WEkigai/Precius/Assets/Renders/Rendered_images/4.png

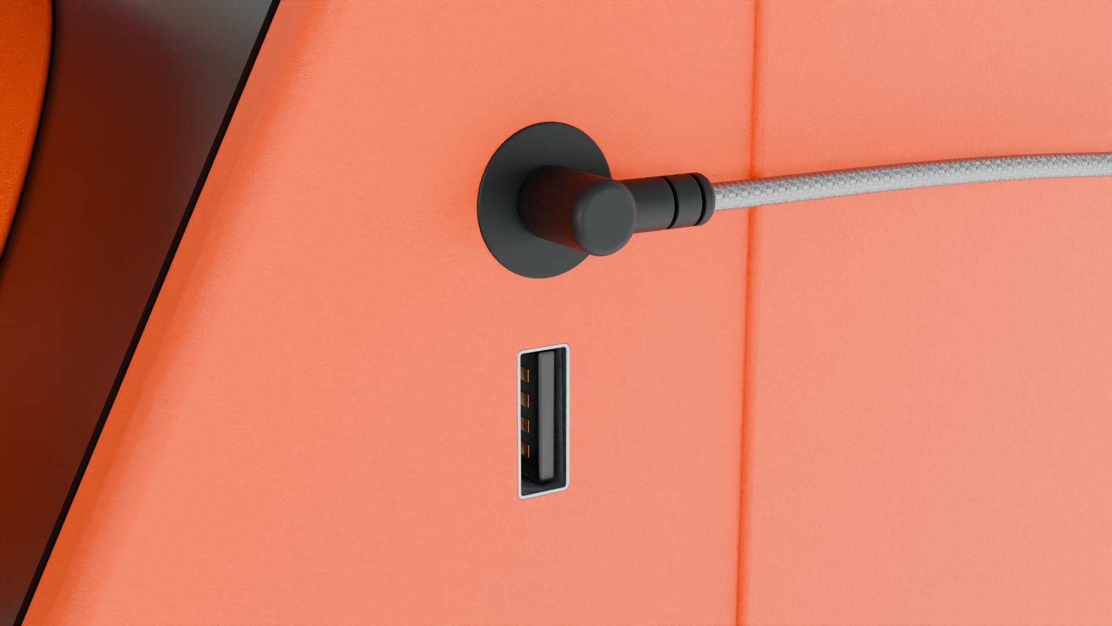
Assets/Renders/Rendered_images/4.png
