WEkigai/Precius/Assets/Renders/Rendered_images/2.png

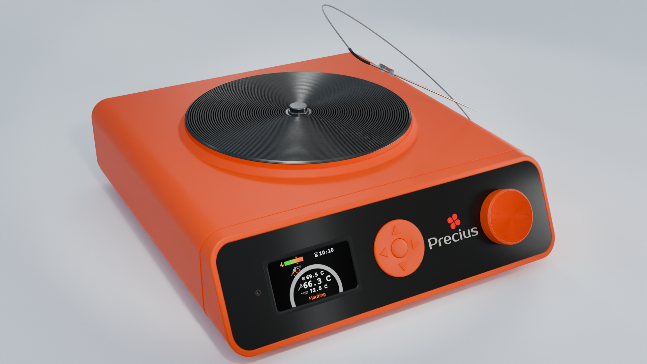
Assets/Renders/Rendered_images/2.png
