WEkigai/Precius/Software/README.md

Software still being built. You can see the code in current state.
