WEkigai/Precius/Assets/Renders/Rendered_images/1.png

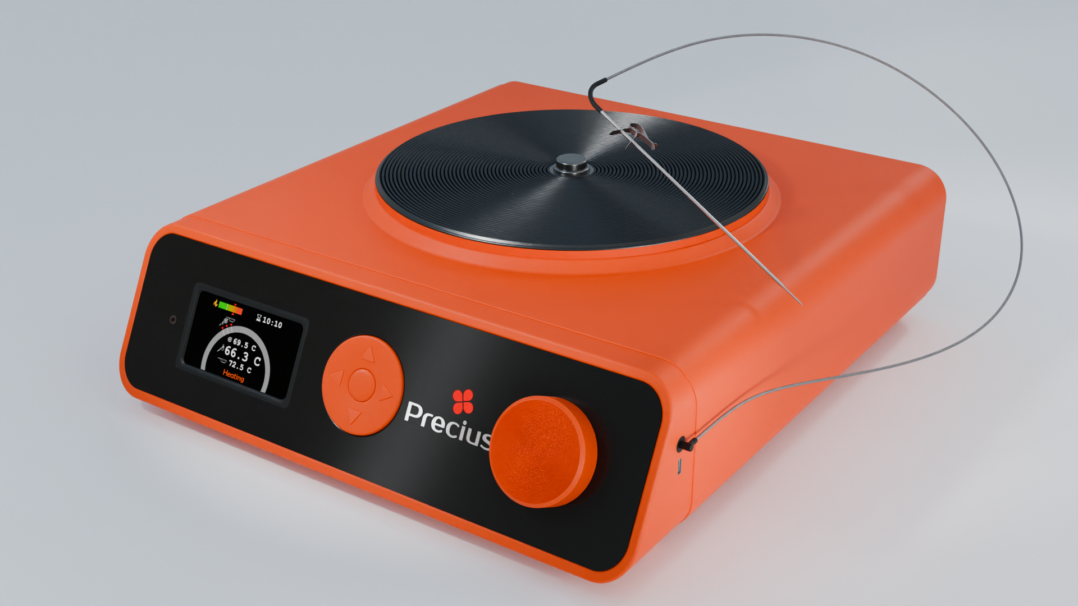
Assets/Renders/Rendered_images/1.png
