WEkigai/Precius/Assets/Renders/Rendered_images/3.png

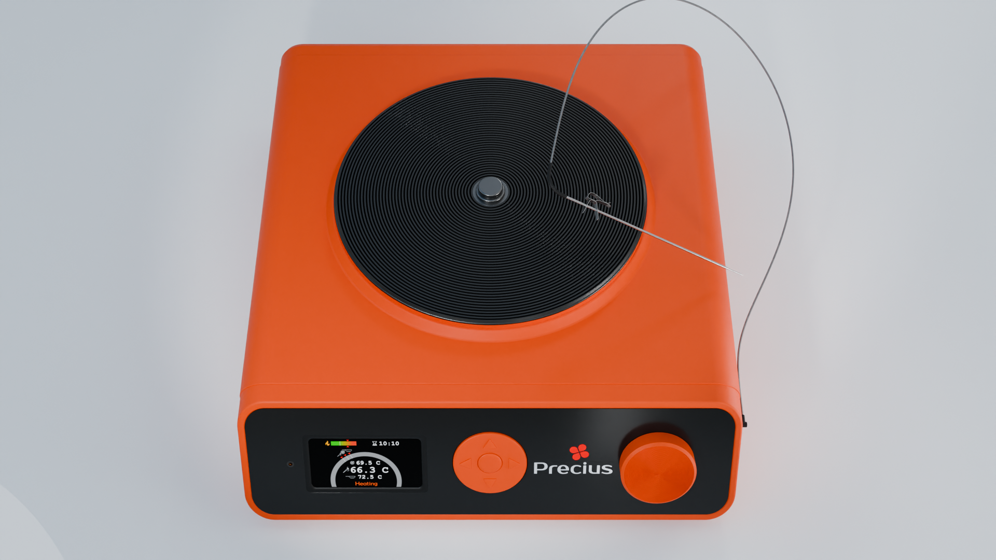
Assets/Renders/Rendered_images/3.png
