WEkigai/Precius/Assets/Renders/Rendered_images/5.png

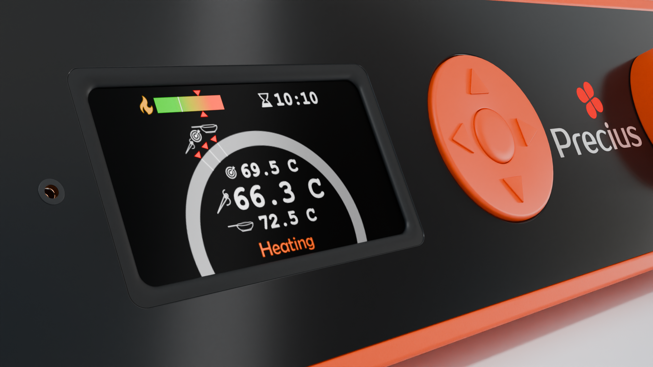
Assets/Renders/Rendered_images/5.png
