WEkigai/Precius/Assets/Renders/Rendered_images/6.png

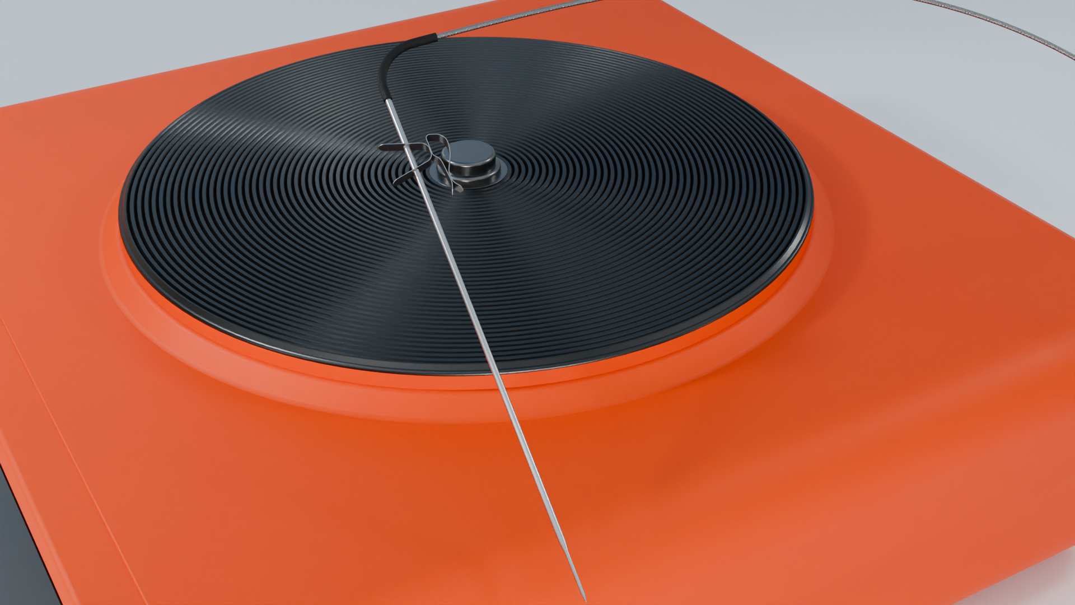
Assets/Renders/Rendered_images/6.png
