WEkigai/Precius/(threads)

Thread 5 (2025-07-05):

Option to use a battery for higher heat output?

lokkju, 2025-07-05:
A common limit is the 1500W draw on a normal household electrical circuit. Since generally high power/heat is needed for only short periods of time - to quickly bring water to a boil, or sear a steak - what about integrating an optional battery to provide that higher burst power?

Thread 6 (2025-08-09):

Conflict between AC connector and fuse holder

WEkigaiDEV, 2025-08-09:
The PCB layout in v0.2 has the pads too close for AC connector and Fuse holder components. This results in conflict during manufacturing.

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

Currently it is solved by manual pressing and resoldering as below.

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

WEkigaiDEV, 2025-08-09:
Fixed by changing the location of fuse holder. Fixed in commit https://github.com/WEkigai/Precius/commit/eb53f17966b7c796f0c6a97542813d14ae6ad821 onwards

Closed 2025-08-09.

Thread 11 (2025-09-01):

Improve PT1000 calculation

WEkigaiDEV, 2025-09-01:
Implement look-up table for PT1000 sensor instead of linear interpolation
https://stackoverflow.com/questions/30012866/how-to-read-temperature-using-arduino-uno-board-with-pt100-rtd-sensor/35302628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

Closed 2025-09-03.
