WEkigai/Precius/Electronics_Design/Main_Board_Schematic.pdf

# USB

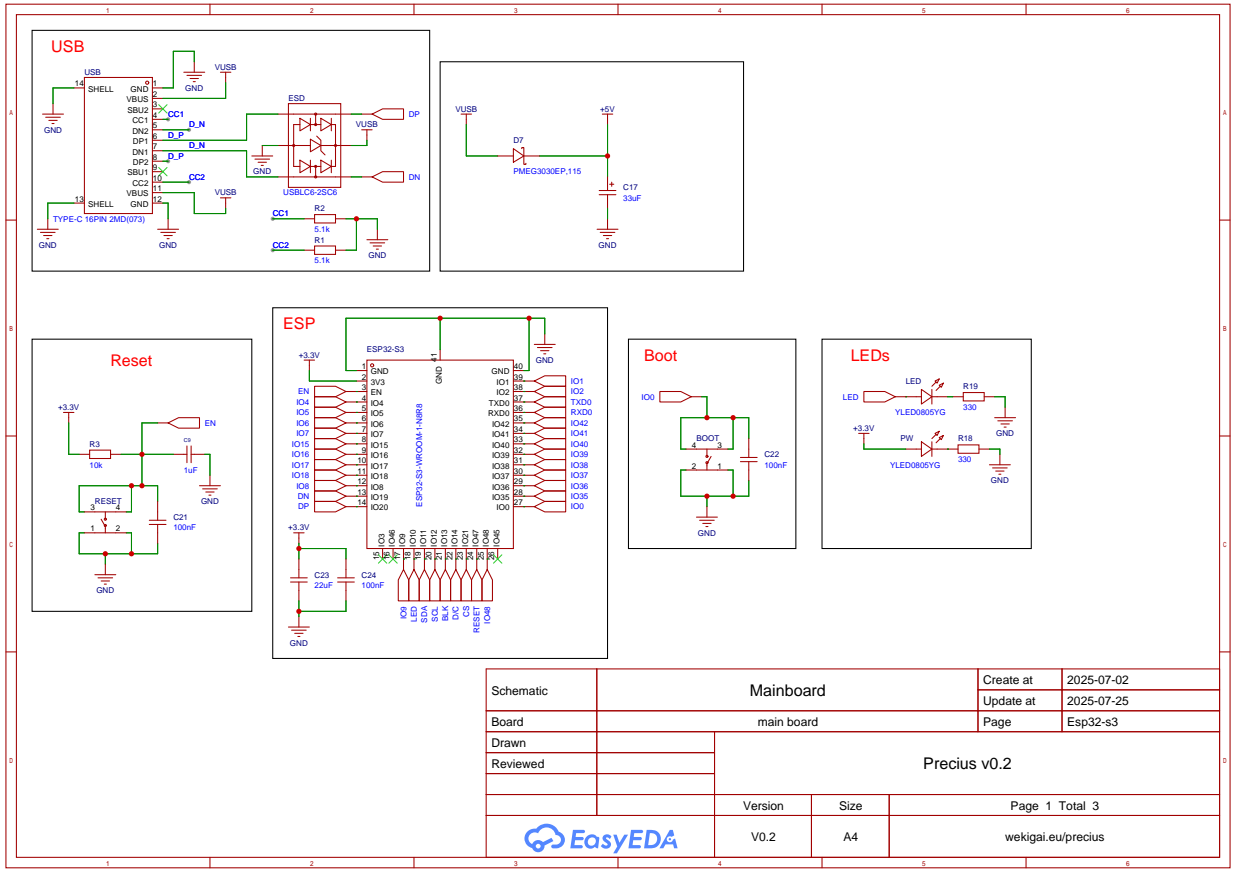
[picture p7: page 1]

Schematic | Mainboard | Create at | 2025-07-02

Update at | 2025-07-25

Board | main board | Page | Esp32-s3
Drawn | | Precius v0.2
Reviewed

Version | Size | Page 1 Total 3

V0.2 | A4 | wekigai.eu/precius

# AC to DC

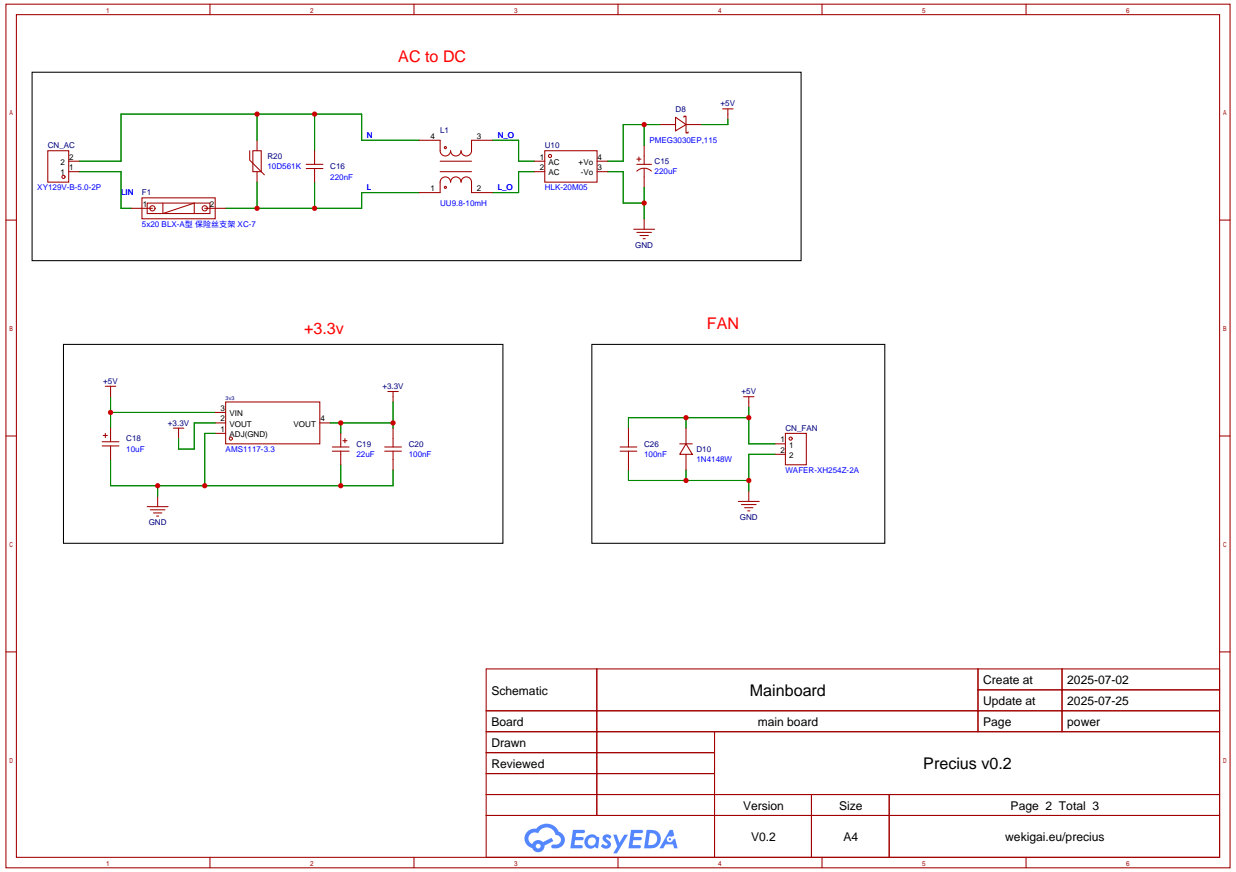
[picture p8: page 2]

LIN
5x20 BLX-A型 保险丝支架 XC-7

Schematic | Mainboard | Create at | 2025-07-02

Update at | 2025-07-25

Board | main board | Page | power
Drawn | | Precius v0.2
Reviewed

Version | Size | Page 2 Total 3

V0.2 | A4 | wekigai.eu/precius

Buzzer | Internal NTC | External RTD | Rotary Encoder

# Buttons (Nav)

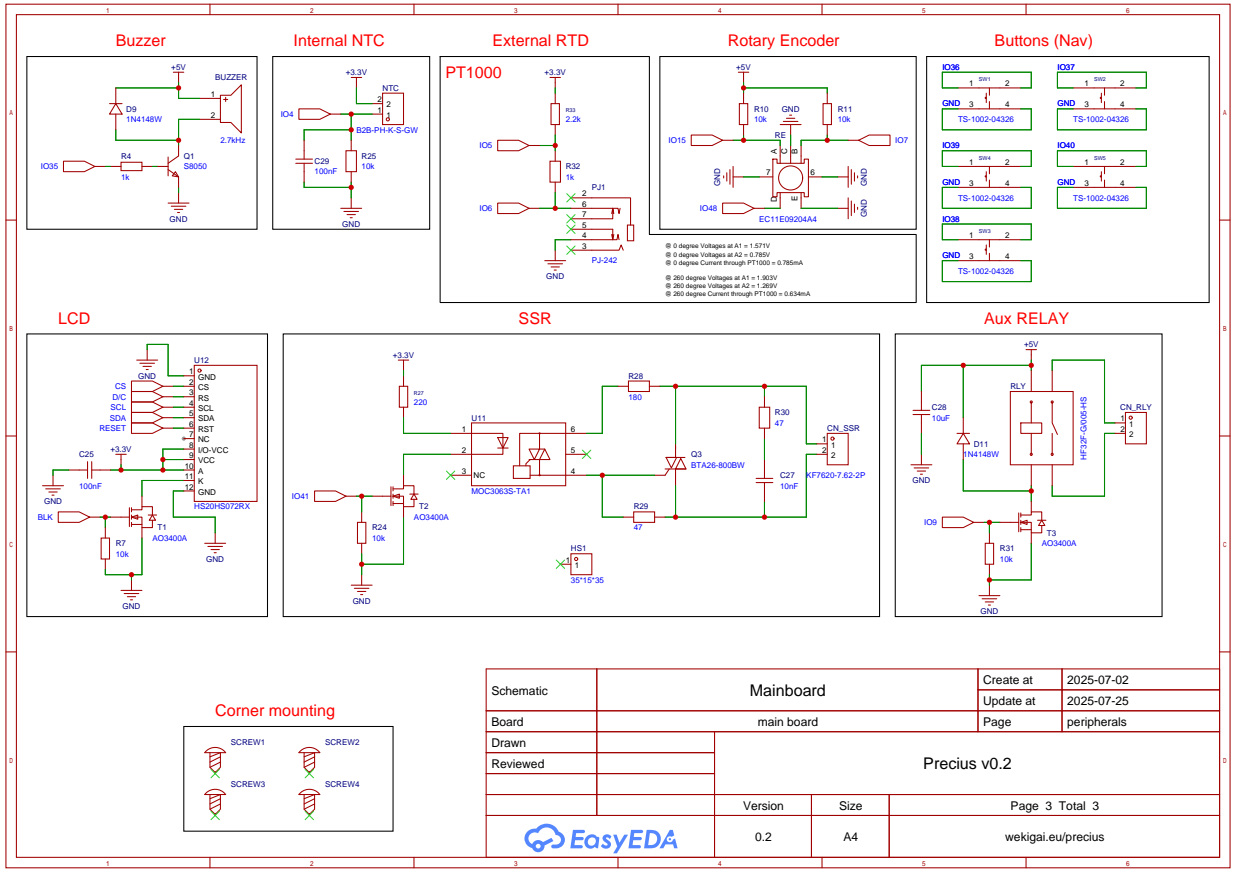
[picture p9: page 3]

Schematic | Mainboard | Create at | 2025-07-02

Update at | 2025-07-25

Board | main board | Page | peripherals
Drawn | | Precius v0.2
Reviewed

Version | Size | Page 3 Total 3

0.2 | A4 | wekigai.eu/precius
