WEkigai/Precius/Software/Precius_Main/Precius_Main.ino

/*------------------------------------
Precius Precision Cooktop
Developed by WEkigai B.V. 
Released under GLPv3. See included license file on Github. Libraries used may have been licensed under other licenses.

Know more: https://wekigai.eu/precius
Main project page https://github.com/WEkigai/Precius 

------------------------------------------*/

/* This version is compatible with hardware version 0.2*/

// Include libraries
#include <Arduino.h>
#include <SPI.h>
#include <Adafruit_GFX.h>
#include <Adafruit_ST7789.h>
#include <ArduPID.h>
#include <math.h>
#include <Encoder.h>
#include <Button2.h>

// Define all hardware pinouts

// Inputs

/// Buttons
#define BUTTON_DOWN_PIN 36
Button2 button_down(BUTTON_DOWN_PIN, true);

#define BUTTON_RIGHT_PIN 37
Button2 button_right(BUTTON_RIGHT_PIN, true);

#define BUTTON_MID_PIN 38 
Button2 button_mid(BUTTON_MID_PIN, true);

#define BUTTON_LEFT_PIN 39
Button2 button_left(BUTTON_LEFT_PIN, true);

#define BUTTON_UP_PIN 40
Button2 button_up(BUTTON_UP_PIN, true);

/// Encoder Knob

#define ENC_A 15
#define ENC_B 7
#define BUTTON_ENC_PIN 48  // Encoder button
Button2 button_enc(BUTTON_ENC_PIN,true);

// Encoder variables
volatile int encoderValue = -998;
volatile int lastStateA = 0;
int lastEncoderValue = -999;
int enc_change=0;

/// Temperature sensors
//// Bottom sensor
#define BASE_SENSOR_PIN 4

//// Probe sensor
/// Pseudo 3 wire implementation after https://raspberrypi.stackexchange.com/questions/54760/ads1115-pt100-circuit 
#define PROBE_SENSOR_PIN_HIGH 5
#define PROBE_SENSOR_PIN_LOW 6 

// Outputs
/// Heater output realy (using LED pin for easy debug)
#define RELAY_PIN 41 //Relay on pin 41

//Relay for Auxillary power output
#define AUX_RELAY_PIN 9

//Buzzer
#define BUZZER_PIN 35  // Buzzer on pin 35

//LED
#define LED_PIN 10     // LED on pin 10


// Display

// TFT Display Pins (ST7789)
#define TFT_MOSI 11
#define TFT_SCLK 12
#define TFT_CS 21
#define TFT_DC 14
#define TFT_RST 47
#define TFT_BL 13

// Create the ST7789 TFT object using hardware SPI:
Adafruit_ST7789 tft = Adafruit_ST7789(TFT_CS, TFT_DC, TFT_RST);
GFXcanvas16 canvas(320, 240); //Canvas object for rendering display off-screen

// Icons and fonts
#include <Fonts/FreeSansBold18pt7b.h>
#include <Fonts/FreeSansBold12pt7b.h>
#include <Fonts/FreeSerifBold12pt7b.h>

static const unsigned char PROGMEM intensity_icon[] = {0x00,0x00,0x00,0x00,0x00,0x40,0x00,0xc0,0x01,0x80,0x03,0x80,0x07,0x00,0x0f,0xe0,0x01,0xc0,0x03,0x80,0x03,0x00,0x06,0x00,0x04,0x00,0x00,0x00,0x00,0x00,0x00,0x00};
static const unsigned char PROGMEM probe_sensor_icon[] = {0x00,0x08,0x00,0x14,0x00,0x22,0x00,0x51,0x00,0x8a,0x01,0x04,0x02,0x08,0x04,0x10,0x08,0x20,0x10,0x40,0x20,0x80,0x41,0x00,0x82,0x00,0x84,0x00,0x88,0x00,0xf0,0x00};
static const unsigned char PROGMEM target_icon[] = {0x01,0x00,0x03,0x80,0x0d,0x60,0x11,0x10,0x20,0x08,0x20,0x08,0x41,0x04,0xf2,0x9e,0x41,0x04,0x20,0x08,0x20,0x08,0x11,0x10,0x0d,0x60,0x03,0x80,0x01,0x00,0x00,0x00};
static const unsigned char PROGMEM pan_sensor_icon[] = {0x00,0x00,0x01,0x00,0x01,0x00,0x01,0x00,0x01,0x00,0x01,0x00,0x09,0x20,0x07,0xc0,0xe3,0x8e,0xa1,0x0a,0xbf,0xfa,0x80,0x02,0x80,0x02,0xff,0xfe,0x00,0x00,0x00,0x00};


// Temperature variables
double Tset = -1.0;           //The target temperature setpoint
double Tnow = -1.0;           // The current temperature
double T_base = -1.0;        //Temperature of the bottom sensor
double T_probe = -1.0;         // Temperature of the probe sensor
double Calibration_T_base = 0.0; //Calibration (correction) for base sensor. Positive numbers add to measured value.
double Calibration_T_probe = 6.5; //Calibration (correction) for probe sensor. Positive numbers add to measured value.
double dual_mode_buffer = 20;  //The difference in dual mode between probe and bottom sensors

// Power variables
float powerPercent = 50.0;  //Heater power compared to maximum possible power

// Time variables
unsigned long int loopTime;  // The wall clock time at the start of each loop


// Variables for timer
int timer_hours = 0;
int timer_minutes = 10;
int timer_seconds = 0;
unsigned int timer_refresh_period = 1000;  //How often will we decrement the timer (ms)
static boolean flag_timer_refresh = false;
static boolean flag_timer_started = false;
unsigned long timer_refresh_StartTime = 0;

// State/mode variables

enum sensorModes {
  BOTTOM_SENSOR_ONLY,  //Only bottom sensor is used to get actual temperature, probe sensor is ignored
  PROBE_SENSOR_ONLY,   //Only probe sensor is used to get actual temperature, bottom sensor is ignored
  DUAL_MODE,            //Both sensors are used. Actual temperature = max(probe, bottom-dual_mode_buffer)
  MANUL_MODE            //Temperature sensors are ignored and heater power is set by user
};
enum sensorModes sensorMode=BOTTOM_SENSOR_ONLY;


enum timerModes {
  TARGET_AND_HOLD,  //Once target is reached, hold the target indefinitely
  TARGET_AND_STOP,  // Once the target is reached, stop heating
  TARGET_AND_TIMER  // Once the target is reached, start a timer and stop after timer ends
};
timerModes timerMode=TARGET_AND_HOLD;

enum heaterStates {
  HEATER_OFF,  // Heater is powered off (default)
  HEATER_ON    // Heater is powered on
};
heaterStates heaterState=HEATER_OFF;

enum tempUnits { //Temperature units
  UNIT_C,  // Degree Celcius
  UNIT_F   // Degree Farenheit
};
tempUnits tempUnit=UNIT_C;


enum screens { //States for different screens to display
  HOME_SCREEN,  // Home Screen
  TIMER_SELECTION_SCREEN, // Screen for selecting the mode of timer
  TIME_SETTING_SCREEN, //Time setting
  SETTINGS_SCREEN   // Settings screen
};
screens screen=HOME_SCREEN;

// Control variables
// Control type = PID
// PID parameters

ArduPID myPID;  // PID object
double control_output = 0.0;
double Kp=300.0, Ki=0.2, Kd=20000.0; //Parameters for PID control
// Kp=300.0, Ki=0.2, Kd=20000.0 best parameters so far for 80 C target

// Parameters for converting PID output to PWM
unsigned int duty_windowSize = 5000;  //total duty cycle of 5 seconds
unsigned long duty_windowStartTime;   //start time of each duty cycle window
unsigned int duty_cycle = 0;          //number between 0 and duty_windowSize that defines duty cycle

// Hardware parameters
float Vref = 3.3;              // Reference voltage [V]
float analog_levels = 4095.0;  //12 bit resolution of ESP32 analog read

// NTC parameters for base sensor
float R_ref_base = 10000;  // Reference Resistor t [ohm]
float R_0_base = 100000;   // value of rct in T_0 [ohm]
float T_0_base = 298.15;   // use T_0 in Kelvin [K]
float Vout_base = 0.0;     // Vout
float Rout_base = 0.0;     // Rout 
// use the datasheet to get this data.
float beta_base = 3950;  // initial parameters [K]
float TempK_base = 0.0;  // variable output

// NTC parameters for probe sensor. This is a PT1000 sensor
float R_ref_probe = 1000;  // Reference Resistor t [ohm]
float R_0_probe = 1000;   // value of rct in T_0 [ohm]
float T_0_probe = 298.15;   // use T_0 in Kelvin [K]
float Vout_probe_high = 0.0;     // Vout - high pin
float Vout_probe_low = 0.0;     // Vout - low pin
float Rout_probe = 0.0;     // Rout
// use the datasheet to get this data.
//float beta_probe = 3950;  // initial parameters [K] Beta not needed for PT1000
float TempK_probe = 0.0;  // variable output

// Resistance of PT1000 sensor for each 1k increment between 273.15 and 573.15 (0-300C) from https://www.fluke.com/nl-nl/informatie/instrumenten-calculators/pt100-table-generator
float PT1000_Resistances[] = {1000, 1003.9077, 1007.8143, 1011.7197, 1015.624, 1019.5271, 1023.429, 1027.3298, 1031.2294, 1035.1279, 1039.0252, 
                              1042.9214, 1046.8164, 1050.7103, 1054.603, 1058.4946, 1062.385, 1066.2742, 1070.1623, 1074.0492, 1077.935, 
                              1081.8196, 1085.7031, 1089.5854, 1093.4666, 1097.3466, 1101.2254, 1105.1031, 1108.9796, 1112.855, 1116.7292, 
                              1120.6023, 1124.4742, 1128.345, 1132.2146, 1136.0831, 1139.9504, 1143.8165, 1147.6815, 1151.5453, 1155.408, 
                              1159.2695, 1163.1299, 1166.9891, 1170.8472, 1174.7041, 1178.5598, 1182.4144, 1186.2678, 1190.1201, 1193.9713, 
                              1197.8212, 1201.67, 1205.5177, 1209.3642, 1213.2096, 1217.0538, 1220.8968, 1224.7387, 1228.5794, 1232.419, 
                              1236.2574, 1240.0947, 1243.9308, 1247.7658, 1251.5996, 1255.4322, 1259.2637, 1263.094, 1266.9232, 1270.7513, 
                              1274.5781, 1278.4038, 1282.2284, 1286.0518, 1289.8741, 1293.6952, 1297.5151, 1301.3339, 1305.1515, 1308.968, 
                              1312.7833, 1316.5975, 1320.4105, 1324.2224, 1328.0331, 1331.8426, 1335.651, 1339.4582, 1343.2643, 1347.0693, 
                              1350.873, 1354.6756, 1358.4771, 1362.2774, 1366.0766, 1369.8746, 1373.6714, 1377.4671, 1381.2616, 1385.055, 
                              1388.8472, 1392.6383, 1396.4282, 1400.217, 1404.0046, 1407.791, 1411.5763, 1415.3604, 1419.1434, 1422.9253, 
                              1426.7059, 1430.4854, 1434.2638, 1438.041, 1441.8171, 1445.592, 1449.3657, 1453.1383, 1456.9097, 1460.68, 
                              1464.4491, 1468.2171, 1471.9839, 1475.7496, 1479.5141, 1483.2774, 1487.0396, 1490.8006, 1494.5605, 1498.3193, 
                              1502.0768, 1505.8332, 1509.5885, 1513.3426, 1517.0956, 1520.8474, 1524.598, 1528.3475, 1532.0958, 1535.843, 
                              1539.589, 1543.3339, 1547.0776, 1550.8202, 1554.5616, 1558.3018, 1562.0409, 1565.7788, 1569.5156, 1573.2513, 
                              1576.9857, 1580.719, 1584.4512, 1588.1822, 1591.9121, 1595.6408, 1599.3683, 1603.0947, 1606.8199, 1610.544, 
                              1614.2669, 1617.9887, 1621.7093, 1625.4288, 1629.1471, 1632.8642, 1636.5802, 1640.295, 1644.0087, 1647.7212, 
                              1651.4326, 1655.1428, 1658.8519, 1662.5598, 1666.2666, 1669.9722, 1673.6766, 1677.3799, 1681.082, 1684.783, 
                              1688.4828, 1692.1815, 1695.879, 1699.5754, 1703.2706, 1706.9646, 1710.6575, 1714.3492, 1718.0398, 1721.7293, 
                              1725.4175, 1729.1046, 1732.7906, 1736.4754, 1740.1591, 1743.8416, 1747.5229, 1751.2031, 1754.8821, 1758.56, 
                              1762.2367, 1765.9123, 1769.5867, 1773.26, 1776.9321, 1780.603, 1784.2728, 1787.9414, 1791.6089, 1795.2752, 
                              1798.9404, 1802.6044, 1806.2673, 1809.929, 1813.5896, 1817.249, 1820.9072, 1824.5643, 1828.2202, 1831.875, 
                              1835.5286, 1839.1811, 1842.8324, 1846.4826, 1850.1316, 1853.7794, 1857.4261, 1861.0716, 1864.716, 1868.3592, 
                              1872.0013, 1875.6422, 1879.282, 1882.9206, 1886.5581, 1890.1944, 1893.8295, 1897.4635, 1901.0963, 1904.728, 
                              1908.3585, 1911.9879, 1915.6161, 1919.2432, 1922.8691, 1926.4938, 1930.1174, 1933.7398, 1937.3611, 1940.9813, 
                              1944.6002, 1948.218, 1951.8347, 1955.4502, 1959.0646, 1962.6778, 1966.2898, 1969.9007, 1973.5104, 1977.119, 
                              1980.7264, 1984.3327, 1987.9378, 1991.5418, 1995.1446, 1998.7462, 2002.3467, 2005.946, 2009.5442, 2013.1412, 
                              2016.7371, 2020.3318, 2023.9254, 2027.5178, 2031.1091, 2034.6992, 2038.2881, 2041.8759, 2045.4625, 2049.048, 
                              2052.6323, 2056.2155, 2059.7975, 2063.3784, 2066.9581, 2070.5366, 2074.114, 2077.6902, 2081.2653, 2084.8392, 
                              2088.412, 2091.9836, 2095.5541, 2099.1234, 2102.6916, 2106.2586, 2109.8244, 2113.3891, 2116.9526, 2120.515 };


//Parameters to refresh display
unsigned int display_refresh_period = 100;  //milliseconds between display updates
unsigned long display_refresh_StartTime;    //start time of each refresh cycle
static boolean flag_display_refresh = true;  //display refresh flag

//Parameters to refresh the serial output

unsigned int serialout_refresh_period = 10000;  //milliseconds between display updates
unsigned long serialout_refresh_StartTime;    //start time of each refresh cycle
static boolean flag_serialout_refresh = true;  //display refresh flag

//Function prototypes
void do_readTemp();      //Function to handle temperature readings
float read_PT1000(float Rout_probe, float* PT1000_Resistances); // Function to calculate temperature of PT1000 based on the resistance
void do_display();       // Function to handle display
void do_heater();        // Function to handle heater
void do_statemachine();  // Handles all states; sets variables to right value depending on state
void do_timer();         //Handles the timer countdown
void do_control();       // Handles the control algorithm
void do_serialout(); //Function to write the parameters on serial monitor

void up_button_click(Button2& btn);
void up_button_longclick(Button2& btn);
void down_button_click(Button2& btn);
void down_button_longclick(Button2& btn);
void left_button_click(Button2& btn);
void right_button_click(Button2& btn);
void mid_button_click(Button2& btn);
void enc_button_click(Button2& btn);

// Interrupt service routine for the rotary encoder
void IRAM_ATTR readEncoder() {
  int stateA = digitalRead(ENC_A);
  int stateB = digitalRead(ENC_B);
  if (stateA != lastStateA) {
    encoderValue += (stateB != stateA) ? 1 : -1;
  }
  lastStateA = stateA;
}

void setup() 
{

Serial.begin(921600);
Serial.println("Started Serial");

  // Initiate all hardware

  //Sensors
  pinMode(BASE_SENSOR_PIN, INPUT);
  pinMode(PROBE_SENSOR_PIN_HIGH, INPUT);
  pinMode(PROBE_SENSOR_PIN_LOW, INPUT);
  

  ///Buttons
button_up.begin(BUTTON_UP_PIN,INPUT_PULLUP,true);
button_down.begin(BUTTON_DOWN_PIN,INPUT_PULLUP,true);
button_left.begin(BUTTON_LEFT_PIN,INPUT_PULLUP,true);
button_right.begin(BUTTON_RIGHT_PIN,INPUT_PULLUP,true);
button_mid.begin(BUTTON_MID_PIN,INPUT_PULLUP,true);
button_enc.begin(BUTTON_ENC_PIN,INPUT_PULLUP,true);

button_up.setClickHandler(up_button_click);
//button_up.setDebounceTime(80);
button_up.setLongClickTime(400);
button_up.setLongClickDetectedHandler(up_button_longclick);
button_up.setLongClickDetectedRetriggerable(true);

button_down.setClickHandler(down_button_click);
//button_down.setDebounceTime(80);
button_down.setLongClickTime(400);
button_down.setLongClickDetectedHandler(down_button_longclick);
button_down.setLongClickDetectedRetriggerable(true);

button_left.setClickHandler(left_button_click);
//button_left.setDebounceTime(80);
button_right.setClickHandler(right_button_click);
//button_right.setDebounceTime(80);
button_mid.setClickHandler(mid_button_click);
//button_mid.setDebounceTime(80);
button_enc.setClickHandler(enc_button_click);
//button_enc.setDebounceTime(80);



// Encoder
  pinMode(ENC_A, INPUT_PULLUP);
  pinMode(ENC_B, INPUT_PULLUP);
  lastStateA = digitalRead(ENC_A);
  attachInterrupt(digitalPinToInterrupt(ENC_A), readEncoder, CHANGE);


// Display
  SPI.begin(TFT_SCLK, -1, TFT_MOSI, TFT_CS);

  tft.init(240, 320);
  tft.setRotation(3);
  //tft.invertDisplay(0);
  tft.fillScreen(ST77XX_BLACK);
  tft.setTextColor(ST77XX_WHITE);
  tft.setTextSize(4);

  pinMode(TFT_BL, OUTPUT);
  digitalWrite(TFT_BL, HIGH);

  tft.setCursor(80, 100);
  tft.print("Precius");
  delay(2000);
  tft.setCursor(20, 200);
  tft.setTextSize(2);
  tft.print("HW: 0.2, SW: 0.3-dev");
  delay(4000);
  tft.fillScreen(ST77XX_BLACK);


// LED
  pinMode(LED_PIN, OUTPUT);
  digitalWrite(LED_PIN, LOW);

// Relay Pin
  pinMode(RELAY_PIN, OUTPUT);    // Main heater output
  digitalWrite(RELAY_PIN, LOW);  // Start with SSR OFF

//Aux relay pin
  pinMode(AUX_RELAY_PIN,OUTPUT); //Relay pin for Auxillary power
  digitalWrite(AUX_RELAY_PIN, HIGH); //We can keep the auxillary power turned on unless specifically needed to be turned off. It is low volt and open when there is no load.


  // Initiate times
  // setup PID duty cycle window start time
  duty_windowStartTime = millis();
  //setup display refresh period
  display_refresh_StartTime = millis();

  // Initiate control
  myPID.begin(&Tnow, &control_output, &Tset, Kp, Ki, Kd);
  myPID.setOutputLimits(0, duty_windowSize * powerPercent * 0.01);
  myPID.setSampleTime(10000); //Since thermal process is slow, it is enough to run PID only once a few seconds. Running more frequently messes with derivatives due to noise
  myPID.start();
}

void loop() 
{

  loopTime = millis();  // Get loop start time

  // Read temperatures
  do_readTemp();

  // Read buttons
  button_up.loop();
  button_down.loop();
  button_left.loop();
  button_right.loop();
  button_mid.loop();
  button_enc.loop();


//Handle encoder changes


if (encoderValue != lastEncoderValue) {
  //Calculate encoder change
  enc_change=(encoderValue-lastEncoderValue); 
    switch (screen){
      case HOME_SCREEN: {
        Tset = Tset+ enc_change;
        if(Tset<10)Tset=10;
        if(tempUnit==UNIT_C && Tset>260)Tset=260;
        if(tempUnit==UNIT_F && Tset>550)Tset=500;
        break;
      }

      case TIMER_SELECTION_SCREEN: {
        if(enc_change>0){ //encoder is changing positive (clockwise)
        if(timerMode==TARGET_AND_HOLD){
          timerMode=TARGET_AND_STOP;
          break;
        }
        if(timerMode==TARGET_AND_STOP){
          timerMode=TARGET_AND_TIMER;
          break;
        }
        if(timerMode==TARGET_AND_TIMER){
          timerMode=TARGET_AND_HOLD;
          break;
        }
        }

        if(enc_change<0){ //encoder is changing negative (counter-clockwise)
        if(timerMode==TARGET_AND_HOLD){
          timerMode=TARGET_AND_TIMER;
          break;
        }
        if(timerMode==TARGET_AND_STOP){
          timerMode=TARGET_AND_HOLD;
          break;
        }
        if(timerMode==TARGET_AND_TIMER){
          timerMode=TARGET_AND_STOP;
          break;
        }
        }
       break;
      }      
      case TIME_SETTING_SCREEN: {
        timer_minutes=timer_minutes+enc_change;
        if(timer_minutes>59){
          timer_hours++;
          timer_minutes=0;
        }
        break;
      }
      case SETTINGS_SCREEN: {
        break;
      }

    }
//Finally store current encoder value for next loop
    lastEncoderValue = encoderValue;
  }

  // Update states and other variables

  // State machine
  do_statemachine();

  // Perform temperature control
  do_control();


// Update all timers at the end of the loop (heater, display, timer, serialoutput) and set flags to refresh
  //check relay window time
  if (loopTime - duty_windowStartTime > duty_windowSize) {
    //time to shift the Relay Window
    duty_windowStartTime += duty_windowSize;
  }

//Check display refresh time
  if (loopTime - display_refresh_StartTime > display_refresh_period) {
    display_refresh_StartTime += display_refresh_period;
    flag_display_refresh = true;
  }

//Check timer refresh time
  if (loopTime - timer_refresh_StartTime > timer_refresh_period) {
    timer_refresh_StartTime += timer_refresh_period;
    flag_timer_refresh = true;
  }

//Check Serial output refresh time
  if (loopTime - serialout_refresh_StartTime > serialout_refresh_period) {
    serialout_refresh_StartTime += serialout_refresh_period;
    flag_serialout_refresh = true;
  }

  // Update display
  do_display();

  //Update serial output
  do_serialout();

  // Update heater
  do_heater();
}
/* End of loop*/


void do_readTemp() 
{

// Read temperature of base
//We smooth the reading by averaging it over 1000 values

Vout_base=((Vout_base*999.0)+float(analogReadMilliVolts(BASE_SENSOR_PIN))/1000.0)/1000.0;
Rout_base=R_ref_base*(Vref/Vout_base - 1.0);
TempK_base=1.0/(((log(Rout_base/R_0_base))/beta_base)+(1/(T_0_base)));

if((TempK_base<=100 || TempK_base>533.15)&&(sensorMode==BOTTOM_SENSOR_ONLY || sensorMode==DUAL_MODE)){
  TempK_base=273.15; //If reading is out of range, return 0 C
  heaterState=HEATER_OFF; //Turn off heater to prevent thermal runout
}

if(tempUnit==UNIT_C)T_base=Calibration_T_base + TempK_base-273.15;
if(tempUnit==UNIT_F)T_base=Calibration_T_base + ((TempK_base-273.15)*5.0/9.0)-32.0;


// Read temperature of probe
//We smooth the reading by averaging it over 10000 values (more sampling needed because probe sensor is noisier due to not having a capacitor in parallel)
Vout_probe_high=((Vout_probe_high*9999.0)+float(analogReadMilliVolts(PROBE_SENSOR_PIN_HIGH)))/10000.0;
Vout_probe_low=((Vout_probe_low*9999.0)+ float(analogReadMilliVolts(PROBE_SENSOR_PIN_LOW)))/10000.0;
Rout_probe=R_ref_probe*(Vout_probe_low-0.0) / (Vout_probe_high-Vout_probe_low);

/*TempK_probe=273.15+(Rout_probe-1000.0)*(523.15-273.15)/(1940.981-1000.0); // For now, a linear approximation for PT1000 resistances In future to implement https://www.fluke.com/en-us/learn/tools-calculators/pt100-table-generator*/
TempK_probe = 273.15 + read_PT1000(Rout_probe, PT1000_Resistances); // The function returns temperature in C so need to convert to K
if((TempK_probe<=100 || TempK_probe>500)&& (sensorMode==PROBE_SENSOR_ONLY || sensorMode==DUAL_MODE)){
  TempK_probe=273.15; //If reading is out of range, return 0 C
  heaterState=HEATER_OFF; //Turn off heater to prevent thermal runout
}

if(tempUnit==UNIT_C)T_probe=Calibration_T_probe + TempK_probe-273.15;
if(tempUnit==UNIT_F)T_probe=Calibration_T_probe+ ((TempK_probe-273.15)*5.0/9.0)-32.0;
}


float read_PT1000(float Rout_probe, float* PT1000_Resistances){  // Function to calculate temperature of PT1000 based on the resistance

//Check for out of bound values
if ((Rout_probe < PT1000_Resistances[0]) || (Rout_probe > PT1000_Resistances[300]) ){
  heaterState=HEATER_OFF;
  return -99.99;
}

int pos=0; //Start at the start of the temperature range and serch for the resistance value in the PT1000 table
while (Rout_probe > PT1000_Resistances[pos]) pos++;

if (Rout_probe == PT1000_Resistances[pos]) return pos; // If the resistance matches, exactly, we found our temperature
//If not, we need to interolate between neiboring temperatures
float r1=PT1000_Resistances[pos-1];
float r2=PT1000_Resistances[pos];
float k1=pos-1;
float k2=pos;
return k1 + (Rout_probe-r1)/(r2-r1)*(k2-k1);
}


void do_statemachine()
{
  switch (sensorMode) {
    case BOTTOM_SENSOR_ONLY:
      Tnow = T_base;
      break;

    case PROBE_SENSOR_ONLY:
      Tnow = T_probe;
      break;

    case DUAL_MODE:
      Tnow = max(T_probe, T_base - dual_mode_buffer);
      break;
 }

  switch (timerMode) {
    case TARGET_AND_HOLD:
      flag_timer_started=false; //Ensure timer is off / paused
      break;

    case TARGET_AND_STOP:
      if (abs(Tnow -Tset)<1) heaterState = HEATER_OFF;  //If we have exceeded the target temperature, stop heating
      flag_timer_started=false; //Ensure timer is off / paused
      break;

    case TARGET_AND_TIMER:
    if ((abs(Tnow -Tset)<1) && heaterState==HEATER_ON) flag_timer_started=true; //If we have reached the target temperature, we can start the timer. Check for heater state to make sure we do not prematurely start timer before target temperature is set by the user
      do_timer();
      if (timer_hours == 0 && timer_minutes == 0 && timer_seconds == 0) heaterState = HEATER_OFF;  //If the timer is done, turn the heater off
      break;
  }
}

void do_control(){
  if(sensorMode!=MANUL_MODE){ //we are in modes that require control
  //perform PID calculations
  myPID.setOutputLimits(0, duty_windowSize*powerPercent*0.01);
  //myPID.setWindUpLimits(0,2*Tset);//Seeting windup limits based on target temperature. Higher setpoints need higher I term to stabilize temperature due to ambient losses
  //myPID.setWindUpLimits(0, 0.1*duty_windowSize*powerPercent*0.01); //We limit the integratl windup to a fraction of total power output
  //Kd=1000.0*Tset; //We want to keep stable temperature with Kd. Higher temperatures have higher heat loss, needing higher power to stay stable
  myPID.compute();
  duty_cycle=control_output;

  }
  else // We are in manual mode
  {
    duty_cycle=duty_windowSize*powerPercent*0.01;
  }
}

void do_display() {
//if it is time to update display update it and set the refresh flag back to false
  if (flag_display_refresh) {
    //We draw everything on to a canvas and at the end push to display

                                              
if(screen==HOME_SCREEN){
//Serial.println("Home screen");


// Clear display
canvas.fillScreen(ST77XX_BLACK);
canvas.setTextWrap(false);

canvas.drawBitmap(17, 4, intensity_icon, 16, 16, 0xFFFF); //Show intensity icon

canvas.drawRect(5, 20, 41, 180, 0xFFFF); // Outer rectangle for power
canvas.fillRect(12, 25+(170.0-170.0*duty_cycle/duty_windowSize), 25, 170.0*duty_cycle/duty_windowSize, 0xF900); //Actual duty cycle by control algorithm
canvas.fillRect(10, 25+(170.0-170.0*powerPercent/100.0), 30, 5, 0x41F); //Level indicator for set power percent

canvas.setTextColor(0xFFFF);
canvas.setFont(&FreeSerifBold12pt7b);
canvas.setCursor(13, 117);
canvas.printf("%d",int(powerPercent)); // Text for power percent

// Show target temperature icon and value
canvas.drawBitmap(185, 110, target_icon, 15, 16, 0xFFFF);
canvas.setFont(&FreeSansBold12pt7b);
canvas.setTextSize(2);
canvas.setCursor(195, 130);
canvas.printf("%d", int(Tset));

// Show probe temperature icon and value
canvas.drawBitmap(53, 62, probe_sensor_icon, 16, 16, 0xFFFF);
canvas.setTextColor(0xFFFF);
canvas.setTextSize(2);
canvas.setFont(&FreeSansBold18pt7b);
canvas.setCursor(74, 92);
canvas.printf("%.1f", T_probe);

// Show base temperature icon and value
canvas.drawBitmap(52, 157, pan_sensor_icon, 15, 16, 0xFFFF);
canvas.setFont(&FreeSansBold18pt7b);
canvas.setCursor(73, 187);
canvas.printf("%.1f", T_base);

// Show heating mode
canvas.setTextSize(1);
canvas.setFont(&FreeSerifBold12pt7b);
canvas.setTextColor(0x41F);
canvas.setCursor(245, 64);
if(sensorMode==BOTTOM_SENSOR_ONLY)canvas.print("Base");
if(sensorMode==PROBE_SENSOR_ONLY)canvas.print("Probe");
if(sensorMode==DUAL_MODE)canvas.print("Dual");
if(sensorMode==MANUL_MODE)canvas.print("Manual");

// Show heater state
canvas.setTextColor(0xFC00);
canvas.setTextSize(1);
canvas.setFont(&FreeSerifBold12pt7b);
canvas.setCursor(245, 185);
if(heaterState==0)canvas.print("Standby");
if(heaterState==1)canvas.print("Heating");


//Show the timer
if(timerMode==TARGET_AND_TIMER){
canvas.setTextColor(0xFFFF);
canvas.setTextSize(1);
canvas.setFont(&FreeSansBold12pt7b);
canvas.setCursor(200, 25);
canvas.printf("%.2d:%.2d:%.2d",timer_hours,timer_minutes,timer_seconds);
}

}


if(screen==TIMER_SELECTION_SCREEN){
//Serial.println("Timer Selection");

canvas.fillScreen(ST77XX_BLACK);
canvas.setTextColor(ST77XX_WHITE, ST77XX_BLACK);
canvas.setFont(&FreeSerifBold12pt7b);
canvas.setTextSize(1);

//Show the available options. The selected option is shown in a rectangle
if(timerMode==TARGET_AND_HOLD)canvas.drawRect(10,10,200,30,ST77XX_WHITE);
canvas.setCursor(10, 30);
canvas.print("Hold at target");

if(timerMode==TARGET_AND_STOP)canvas.drawRect(10,40,200,30,ST77XX_WHITE);
canvas.setCursor(10, 60);
canvas.print("Stop at target");

if(timerMode==TARGET_AND_TIMER)canvas.drawRect(10,70,200,30,ST77XX_WHITE);
canvas.setCursor(10, 90);
canvas.print("Timer after target");
}


if(screen==TIME_SETTING_SCREEN){
//Serial.println("Time Setting");
canvas.fillScreen(ST77XX_BLACK);
canvas.setTextColor(ST77XX_WHITE, ST77XX_BLACK);
canvas.setFont(&FreeSerifBold12pt7b);
canvas.setTextSize(1);

// Display Mode
canvas.setCursor(10, 20);
canvas.print("HH:");
canvas.setCursor(10, 60);
canvas.print("MM:");
canvas.setCursor(10, 100);
canvas.print("SS");

canvas.setCursor(100, 20);
canvas.print(timer_hours);
canvas.setCursor(100, 60);
canvas.print(timer_minutes);
canvas.setCursor(100, 100);
canvas.print(timer_seconds);

}
  
//At the end, we push the canvas on to the display
tft.drawRGBBitmap(0, 0, canvas.getBuffer(),canvas.width(), canvas.height());

//We are done with refreshing the display for now, so set flag back to false
flag_display_refresh=false;
  }
}


void do_serialout(){
  if(flag_serialout_refresh==true)
  {
    
//We can also use the display refresh to debug PID parameters via serial
myPID.debug(&Serial, "PID", PRINT_INPUT    | // Can include or comment out any of these terms to print
                                              PRINT_OUTPUT   | // in the Serial plotter
                                              PRINT_SETPOINT |
                                              //PRINT_BIAS     |
                                              PRINT_P        |
                                              PRINT_I        |
                                              PRINT_D);

  flag_serialout_refresh=false;
  }

}

void do_heater() {
  if ((duty_cycle >= loopTime - duty_windowStartTime) && (heaterState == HEATER_ON)) {
    digitalWrite(RELAY_PIN, HIGH);
  } else {
    digitalWrite(RELAY_PIN, LOW);
  }
}

void do_timer() {
  if (flag_timer_started==true){ //Check if the timer has started
  if (flag_timer_refresh) {

    if (timer_seconds > 0) {
      timer_seconds--;
    } else {
      if (timer_minutes > 0) {
        timer_minutes--;
        timer_seconds = 59;
      } else {
        if (timer_hours > 0) {
          timer_hours--;
          timer_minutes = 59;
          timer_seconds = 59;
        }
      }
    }
    flag_timer_refresh=false; // Now we have updated the timer, so set the flag back to false
  }
  }
}

void up_button_click(Button2& btn){
  switch (screen){
    case HOME_SCREEN:{ //On home screen, up will increment power percent
      powerPercent++;
      if(powerPercent>100)powerPercent=100;
      break;
    }
  }
}

void up_button_longclick(Button2& btn){
  switch (screen){
    case HOME_SCREEN:{ //On home screen, up will increment power percent
      powerPercent+=10;
      if(powerPercent>100)powerPercent=100;
      break;
    }
  }
}
void down_button_click(Button2& btn){

  switch (screen){
    case HOME_SCREEN:{ //On home screen, down will decrement power percent
      powerPercent--;
      if(powerPercent<0)powerPercent=0;
      break;
    }
  }
}

void down_button_longclick(Button2& btn){

  switch (screen){
    case HOME_SCREEN:{ //On home screen, down will decrement power percent
      powerPercent-=10;
      if(powerPercent<0)powerPercent=0;
      break;
    }
  }
}


void left_button_click(Button2& btn){

  switch (screen){
    case HOME_SCREEN:{ //On home screen, left will change modes
      if(sensorMode==BOTTOM_SENSOR_ONLY){
        sensorMode=MANUL_MODE;
        break;
      }
      if(sensorMode==MANUL_MODE){
        sensorMode=DUAL_MODE;
        break;
      }
      if(sensorMode==DUAL_MODE){
        sensorMode=PROBE_SENSOR_ONLY;
        break;
      }
      if(sensorMode==PROBE_SENSOR_ONLY){
        sensorMode= BOTTOM_SENSOR_ONLY;
        break;
      }
      break;
    }
  }
}

void right_button_click(Button2& btn){

  switch (screen){
    case HOME_SCREEN:{ //On home screen, right will change modes
      if(sensorMode==BOTTOM_SENSOR_ONLY){
        sensorMode=PROBE_SENSOR_ONLY;
        break;
        }
      if(sensorMode==PROBE_SENSOR_ONLY){
        sensorMode=DUAL_MODE;
        break;
      }
      if(sensorMode==DUAL_MODE){
        sensorMode=MANUL_MODE;
        break;
      }
      if(sensorMode==MANUL_MODE){
        sensorMode= BOTTOM_SENSOR_ONLY;
        break;
      }
      break;
    }
  }
}

void mid_button_click(Button2& btn){

  switch (screen){
    case HOME_SCREEN:{ //On home screen, mid button will start/stop heating
      if(heaterState==HEATER_OFF){
        heaterState=HEATER_ON;
        break;
      }
      if(heaterState==HEATER_ON){
        heaterState=HEATER_OFF;
        break;
      }
    break;
    }
  }
}

void enc_button_click(Button2& btn){
tft.fillScreen(ST77XX_BLACK);
if(screen==HOME_SCREEN){
  screen=TIMER_SELECTION_SCREEN;
  return;
  }
if(screen==TIMER_SELECTION_SCREEN){
  if(timerMode==TARGET_AND_TIMER){
    screen=TIME_SETTING_SCREEN;
    return;
  }
  else
  screen=HOME_SCREEN;
  return;
  }  
if(screen==TIME_SETTING_SCREEN){
  screen=HOME_SCREEN;
  return;
  }

}
