WEkigai/Precius/(commit log)

2025-03-24 Added CAD and PCB files
    Adding STEP and Gerber files
2025-03-24 Updated links to design files
    Added links to proto CAD and PCB files in tasks
2025-03-24 Industrial Design
    Uploaded STL file
2025-03-25 first version of the main board
2025-03-25 Update README.md
    Added material specifications
2025-04-16 Updated CAD file
    Latest heater and sensor design
2025-04-21 First version of code
    First version uploaded. Still a lot of bugs. Not ready for use.
    [Precius_Main.ino]
2025-04-21 Smooth analog reading
    Samples 20 readings from sensor and averages to get a smooth value.
2025-04-22 Smaller increments of temperature
    Now the increments can be single digit degrees
2025-04-25 Added GUI
    - Added a GUI
    - Shows set power level and actual output from controller
2025-04-25 Added error detection for rouout
    Added some basic input checks for sensor and checks to prevent thermal runout with missing sensors
    [Precius_Main.ino]
2025-04-28 Minor fixes
    Fixed color and minor render issues
    [Precius_Main.ino]
2025-05-04 GUI and general updates
    Improved GUI with black background. Added screen for timer mode selection.
    Other general improvements.
2025-05-04 Commented unnecessary serial print
2025-05-04 Fixed bugs around timer screen
    Fixed logic around timer setting screen.
    Fixed logic around display and timer refreshes.
    [Precius_Main.ino]
2025-05-05 Implemented timer
    Implemented basic timer functionality and display
2025-05-09 Parametrized PID
    Included PID parameters. Other minor improvements.
2025-05-19 Improved PID parameters
    Improved PID parameters and some minor improvements to GUI
2025-08-06 Adding updated versions for PCB design
    Added files for version 0.2 PCB. Includes on board SSR and some other improvements.
2025-08-15 First version for PCB v0.2
    First stable version working with PCB v0.2
2025-08-17 Improved smoothening of tempertures
    Changed the algorithm to smooth temperature readings. Added version info to splash screen.
2025-08-26 Included support for Auxiliary power
    Added code to support Auxiliary power relay
2025-09-03 Improved PT1000 readings
    Used resistance table to calculate PT1000 sensor readings. Closes #11
